cnvogelg/pardroid/README.md

The parbox project implements an external device attached to the
Amiga parallel port that allows to directly connect network or mass
storage devices.

Currently, devices based on Atmel's AVR8 controllers are supported on the
device side.
