cnvogelg/pardroid/docs/index.rst

The parbox Project
==================

.. toctree::
    :maxdepth: 2
    :hidden:

    pamela

The ``parbox`` project allows to attach 8 and 32 bit microcontrollers directly
to the parallel port of a classic Amiga computer. On multiple data channels
you can transfer data from and to attached SPI and I2C devices including
Ethernet network devices, SD Cards, small displays or real time clocks.

Contents
--------

* :doc:`pamela` - the parallel messaging layer description

Project Links
-------------

* Source is hosted on `GitHub <https://github.com/cnvogelg/parbox>`_
* docs are hosted on `ReadTheDocs <https://readthedocs.org/projects/parbox>`_
