cnvogelg/pardroid/hardware/pb_cpu_pipico/pb_cpu_pipico.kicad_pcb

## KiCad design hardware/pb_cpu_pipico/pb_cpu_pipico.kicad_pcb (2022-03-01)

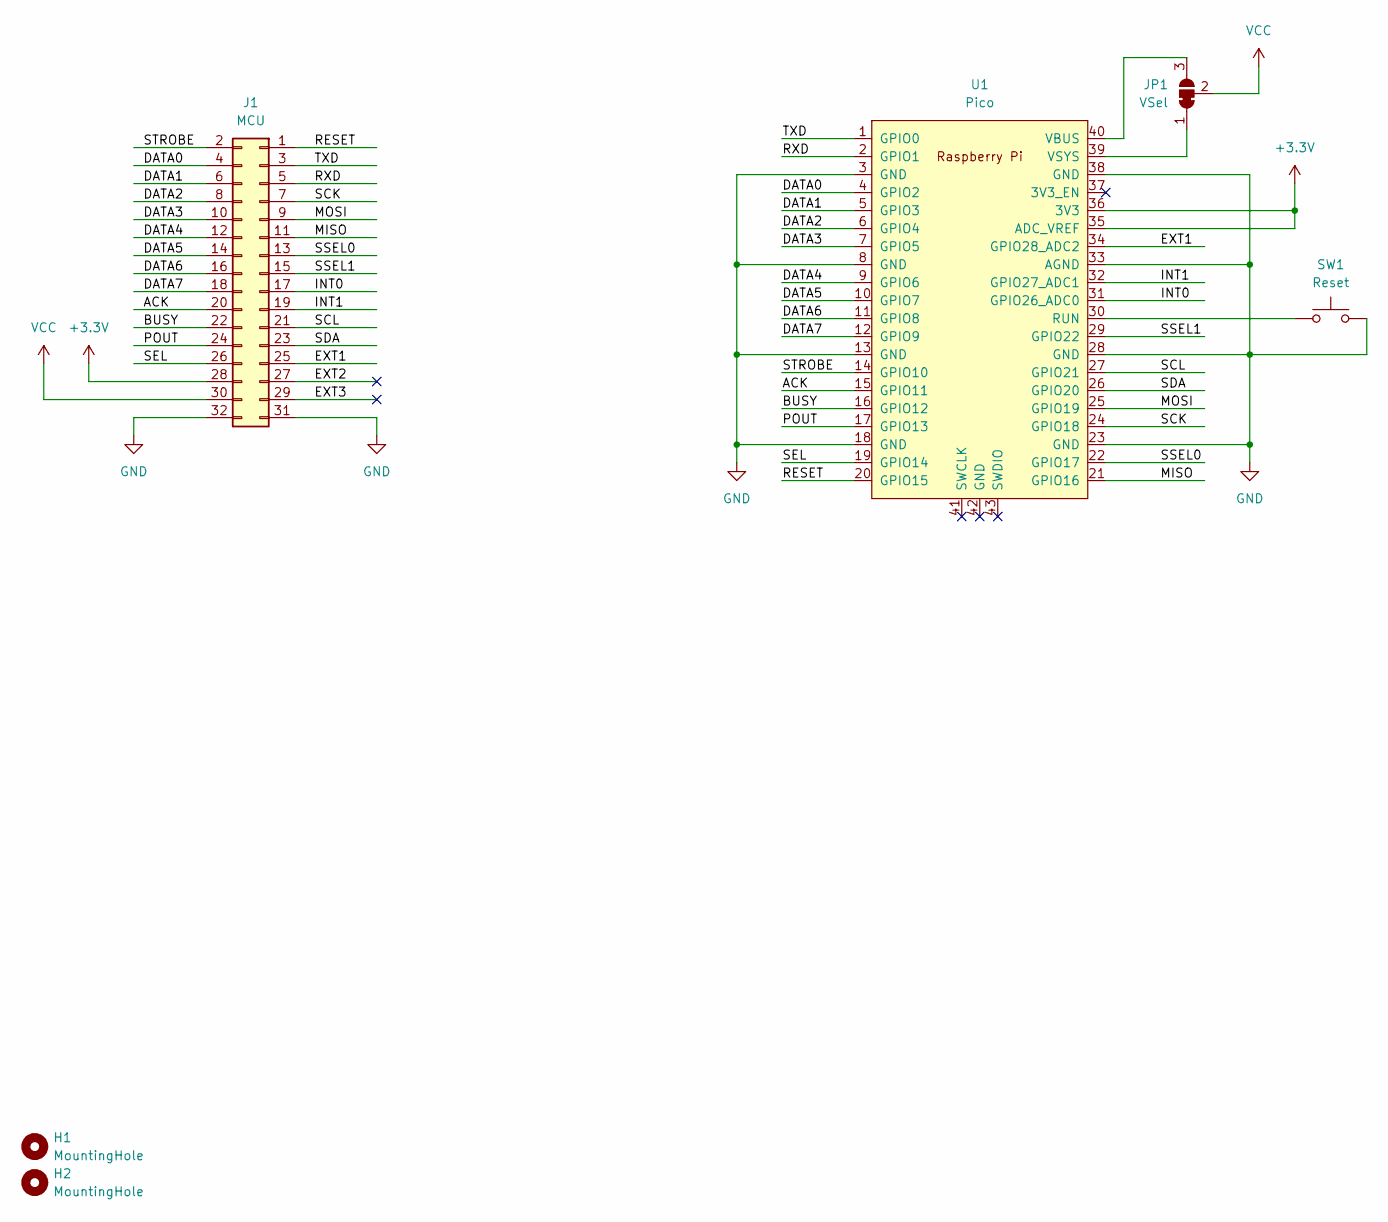
[picture p1: schematic pb_cpu_pipico.kicad_sch, AmiParBox CPU Board Pi Pico]

Parts:
H1, H2: MountingHole; MountingHole_3.2mm_M3_Pad
J1: MCU; PinHeader_2x16_P2.54mm_Vertical
JP1: VSel; SolderJumper-3_P1.3mm_Bridged2Bar12_Pad1.0x1.5mm
SW1: Reset; SW_PUSH_6mm
U1: Pico; RPi_Pico_SMD_TH

Connections:
+3V3: J1.28, U1.35 (ADC_VREF), U1.36 (3V3)
/ACK: J1.20, U1.15 (GPIO11)
/BUSY: J1.22, U1.16 (GPIO12)
/DATA0: J1.4, U1.4 (GPIO2)
/DATA1: J1.6, U1.5 (GPIO3)
/DATA2: J1.8, U1.6 (GPIO4)
/DATA3: J1.10, U1.7 (GPIO5)
/DATA4: J1.12, U1.9 (GPIO6)
/DATA5: J1.14, U1.10 (GPIO7)
/DATA6: J1.16, U1.11 (GPIO8)
/DATA7: J1.18, U1.12 (GPIO9)
/EXT1: J1.25, U1.34 (GPIO28_ADC2)
/EXT2: J1.27
/EXT3: J1.29
/INT0: J1.17, U1.31 (GPIO26_ADC0)
/INT1: J1.19, U1.32 (GPIO27_ADC1)
/MISO: J1.11, U1.21 (GPIO16)
/MOSI: J1.9, U1.25 (GPIO19)
/POUT: J1.24, U1.17 (GPIO13)
/RESET: J1.1, U1.20 (GPIO15)
/RXD: J1.5, U1.2 (GPIO1)
/SCK: J1.7, U1.24 (GPIO18)
/SCL: J1.21, U1.27 (GPIO21)
/SDA: J1.23, U1.26 (GPIO20)
/SEL: J1.26, U1.19 (GPIO14)
/SSEL0: J1.13, U1.22 (GPIO17)
/SSEL1: J1.15, U1.29 (GPIO22)
/STROBE: J1.2, U1.14 (GPIO10)
/TXD: J1.3, U1.1 (GPIO0)
GND: J1.31, J1.32, SW1.2, U1.3 (GND), U1.8 (GND), U1.13 (GND), U1.18 (GND), U1.23 (GND), U1.28 (GND), U1.33 (AGND), U1.38 (GND)
unnamed: JP1.1 (A), U1.39 (VSYS)
unnamed: JP1.3 (B), U1.40 (VBUS)
unnamed: SW1.1, U1.30 (RUN)
VCC: J1.30, JP1.2 (C)

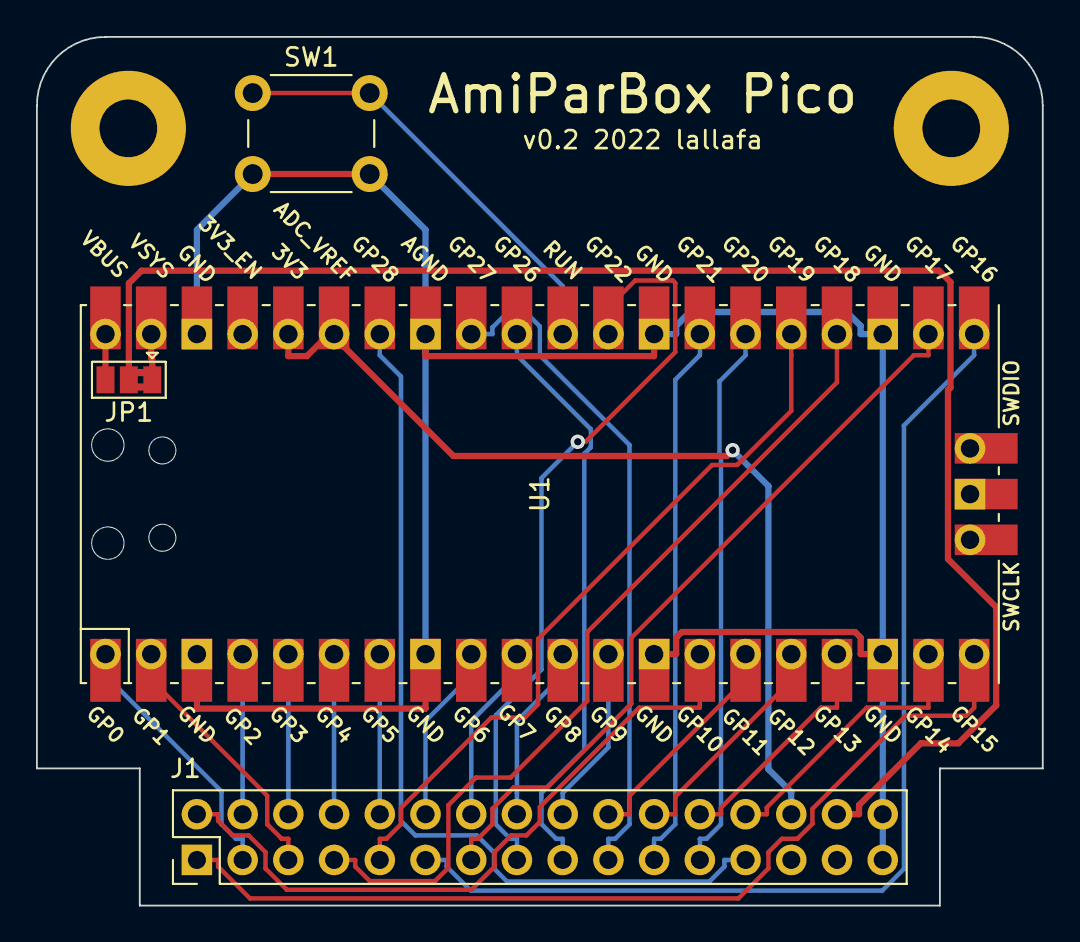
[picture p2: board pb_cpu_pipico.kicad_pcb from above]

Board: 2 copper layers, 55.9 x 48.3 mm, 6 parts (0 on the bottom side), 32 nets.
