cnvogelg/pardroid/hardware/pb_base/pb_base.kicad_pcb

## KiCad design hardware/pb_base/pb_base.kicad_pcb (2022-03-01)

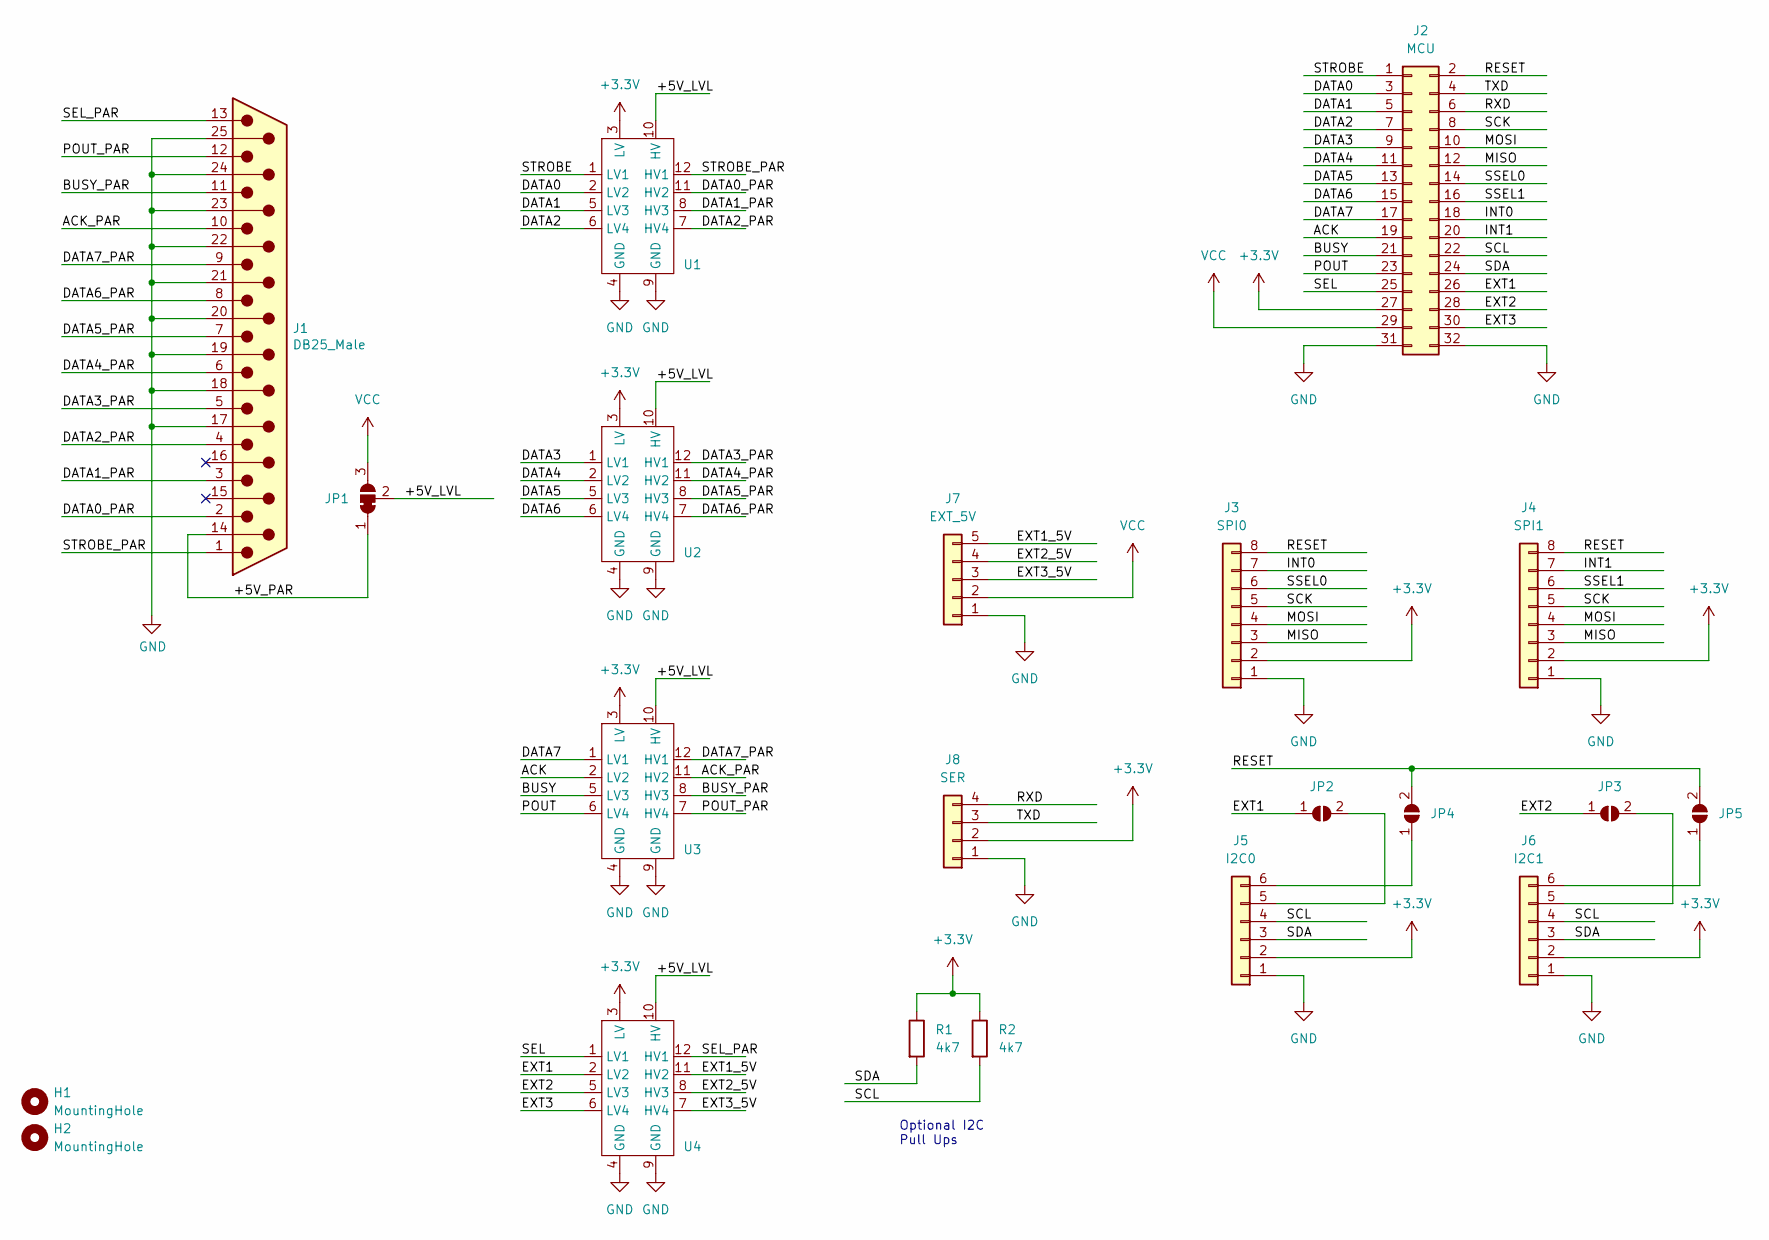
[picture p3: schematic pb_base.kicad_sch, ParBox Base Board]

Parts:
H1, H2: MountingHole; MountingHole_3.2mm_M3_Pad
J1: DB25_Male; DSUB-25_Male_Horizontal_P2.77x2.84mm_EdgePinOffset7.70mm_Ho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
J2: MCU; PinHeader_2x16_P2.54mm_Vertical
J3: SPI0; PinHeader_1x08_P2.54mm_Vertical
J4: SPI1; PinHeader_1x08_P2.54mm_Vertical
J5: I2C0; PinHeader_1x06_P2.54mm_Vertical
J6: I2C1; PinHeader_1x06_P2.54mm_Vertical
J7: EXT_5V; PinHeader_1x05_P2.54mm_Vertical
J8: SER; PinHeader_1x04_P2.54mm_Vertical
JP1: SolderJumper_3_Bridged12; PinHeader_1x03_P2.54mm_Vertical
JP2, JP3, JP4, JP5: SolderJumper_2_Open; PinHeader_1x02_P2.54mm_Vertical
R1, R2: 4k7; R_Axial_DIN0204_L3.6mm_D1.6mm_P5.08mm_Horizontal
U1, U2, U3, U4: LevelShifter_4; DIP-12_W10.16mm_LongPads

Connections:
+3V3: J2.27, J3.2, J4.2, J5.2, J6.2, J8.2, R1.1, R2.1, U1.3 (LV), U2.3 (LV), U3.3 (LV), U4.3 (LV)
/+5V_LVL: JP1.2 (C), U1.10 (HV), U2.10 (HV), U3.10 (HV), U4.10 (HV)
/+5V_PAR: J1.14, JP1.1 (A)
/ACK: J2.19, U3.2 (LV2)
/ACK_PAR: J1.10, U3.11 (HV2)
/BUSY: J2.21, U3.5 (LV3)
/BUSY_PAR: J1.11, U3.8 (HV3)
/DATA0: J2.3, U1.2 (LV2)
/DATA0_PAR: J1.2, U1.11 (HV2)
/DATA1: J2.5, U1.5 (LV3)
/DATA1_PAR: J1.3, U1.8 (HV3)
/DATA2: J2.7, U1.6 (LV4)
/DATA2_PAR: J1.4, U1.7 (HV4)
/DATA3: J2.9, U2.1 (LV1)
/DATA3_PAR: J1.5, U2.12 (HV1)
/DATA4: J2.11, U2.2 (LV2)
/DATA4_PAR: J1.6, U2.11 (HV2)
/DATA5: J2.13, U2.5 (LV3)
/DATA5_PAR: J1.7, U2.8 (HV3)
/DATA6: J2.15, U2.6 (LV4)
/DATA6_PAR: J1.8, U2.7 (HV4)
/DATA7: J2.17, U3.1 (LV1)
/DATA7_PAR: J1.9, U3.12 (HV1)
/EXT1: J2.26, JP2.1 (A), U4.2 (LV2)
/EXT1_5V: J7.5, U4.11 (HV2)
/EXT2: J2.28, JP3.1 (A), U4.5 (LV3)
/EXT2_5V: J7.4, U4.8 (HV3)
/EXT3: J2.30, U4.6 (LV4)
/EXT3_5V: J7.3, U4.7 (HV4)
/INT0: J2.18, J3.7
/INT1: J2.20, J4.7
/MISO: J2.12, J3.3, J4.3
/MOSI: J2.10, J3.4, J4.4
/POUT: J2.23, U3.6 (LV4)
/POUT_PAR: J1.12, U3.7 (HV4)
/RESET: J2.2, J3.8, J4.8, JP4.2 (B), JP5.2 (B)
/RXD: J2.6, J8.4
/SCK: J2.8, J3.5, J4.5
/SCL: J2.22, J5.4, J6.4, R2.2
/SDA: J2.24, J5.3, J6.3, R1.2
/SEL: J2.25, U4.1 (LV1)
/SEL_PAR: J1.13, U4.12 (HV1)
/SSEL0: J2.14, J3.6
/SSEL1: J2.16, J4.6
/STROBE: J2.1, U1.1 (LV1)
/STROBE_PAR: J1.1, U1.12 (HV1)
/TXD: J2.4, J8.3
GND: J1.17, J1.18, J1.19, J1.20, J1.21, J1.22, J1.23, J1.24, J1.25, J2.31, J2.32, J3.1, J4.1, J5.1, J6.1, J7.1, J8.1, U1.4 (GND), U1.9 (GND), U2.4 (GND), U2.9 (GND), U3.4 (GND), U3.9 (GND), U4.4 (GND), U4.9 (GND)
unnamed: J5.5, JP2.2 (B)
unnamed: J5.6, JP4.1 (A)
unnamed: J6.5, JP3.2 (B)
unnamed: J6.6, JP5.1 (A)
VCC: J2.29, J7.2, JP1.3 (B)

Notes on the sheet:
Optional I2C Pull Ups

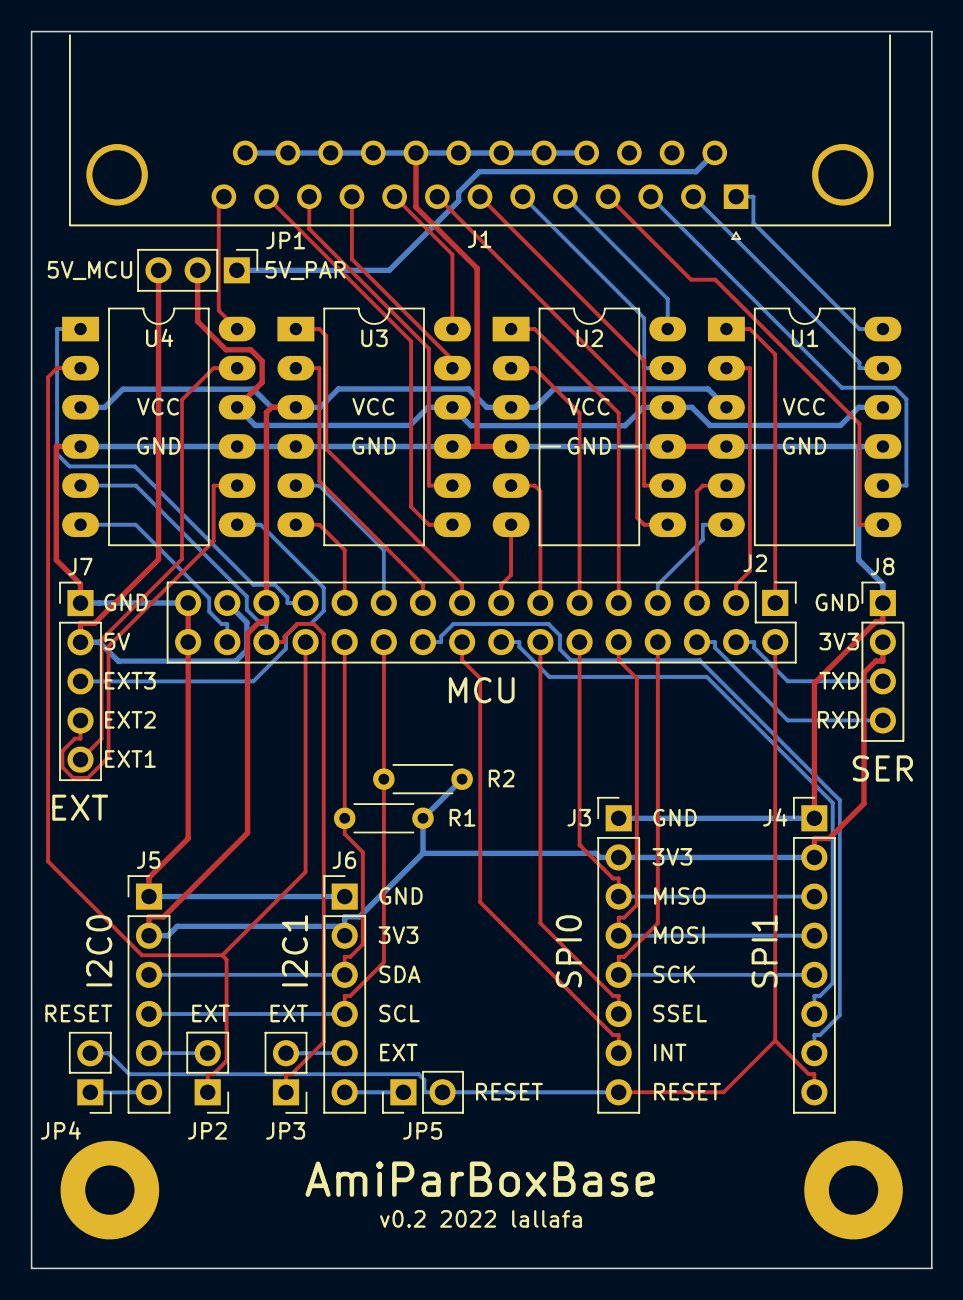
[picture p4: board pb_base.kicad_pcb from above]

Board: 2 copper layers, 58.4 x 80.3 mm, 21 parts (0 on the bottom side), 53 nets.
