cnvogelg/pardroid/hardware/pb_spi_net/pb_spi_net.kicad_pcb

## KiCad design hardware/pb_spi_net/pb_spi_net.kicad_pcb (2022-02-11)

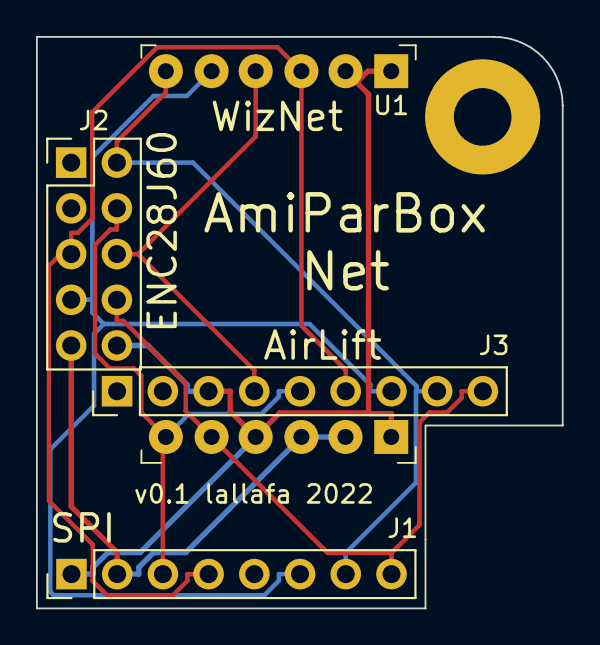
[picture p5: board pb_spi_net.kicad_pcb from above]

Board: 2 copper layers, 29.2 x 31.8 mm, 5 parts (0 on the bottom side), 8 nets.

Parts:
H1: MountingHole; MountingHole_3.2mm_M3_Pad
J1: SPI; PinHeader_1x08_P2.54mm_Vertical
J2: ENC28J60 Module; PinHeader_2x05_P2.54mm_Vertical
J3: AirLift; PinHeader_1x09_P2.54mm_Vertical
U1: WIZ820IO; Mag_Jack_Module_WIZ820IO

Connections:
+3V3: J1.2, J2.9, U1.J2-2 (3V3D), U1.J2-3 (3V3D)
/INT: J1.7, J2.2, J3.8, U1.J1-6 (nINT)
/MISO: J1.3, J2.4, J3.5, U1.J2-6 (MISO)
/MOSI: J1.4, J2.5, J3.6, U1.J1-3 (MOSI)
/RESET: J1.8, J2.8, J3.9, U1.J2-5 (nRESET)
/SCLK: J2.6, J3.4, U1.J1-4 (SCLK)
/SSEL: J1.6, J2.7, J3.7, U1.J1-5 (nSS)
GND: J1.1, J2.10, J3.3, U1.J1-1 (GND), U1.J1-2 (GND), U1.J2-1 (GND), U1.J2-4 (PWDN)
