cnvogelg/pardroid/hardware/teensy2.0/parbox_t2.kicad_pcb

## KiCad design hardware/teensy2.0/parbox_t2.kicad_pcb (2020-01-22)

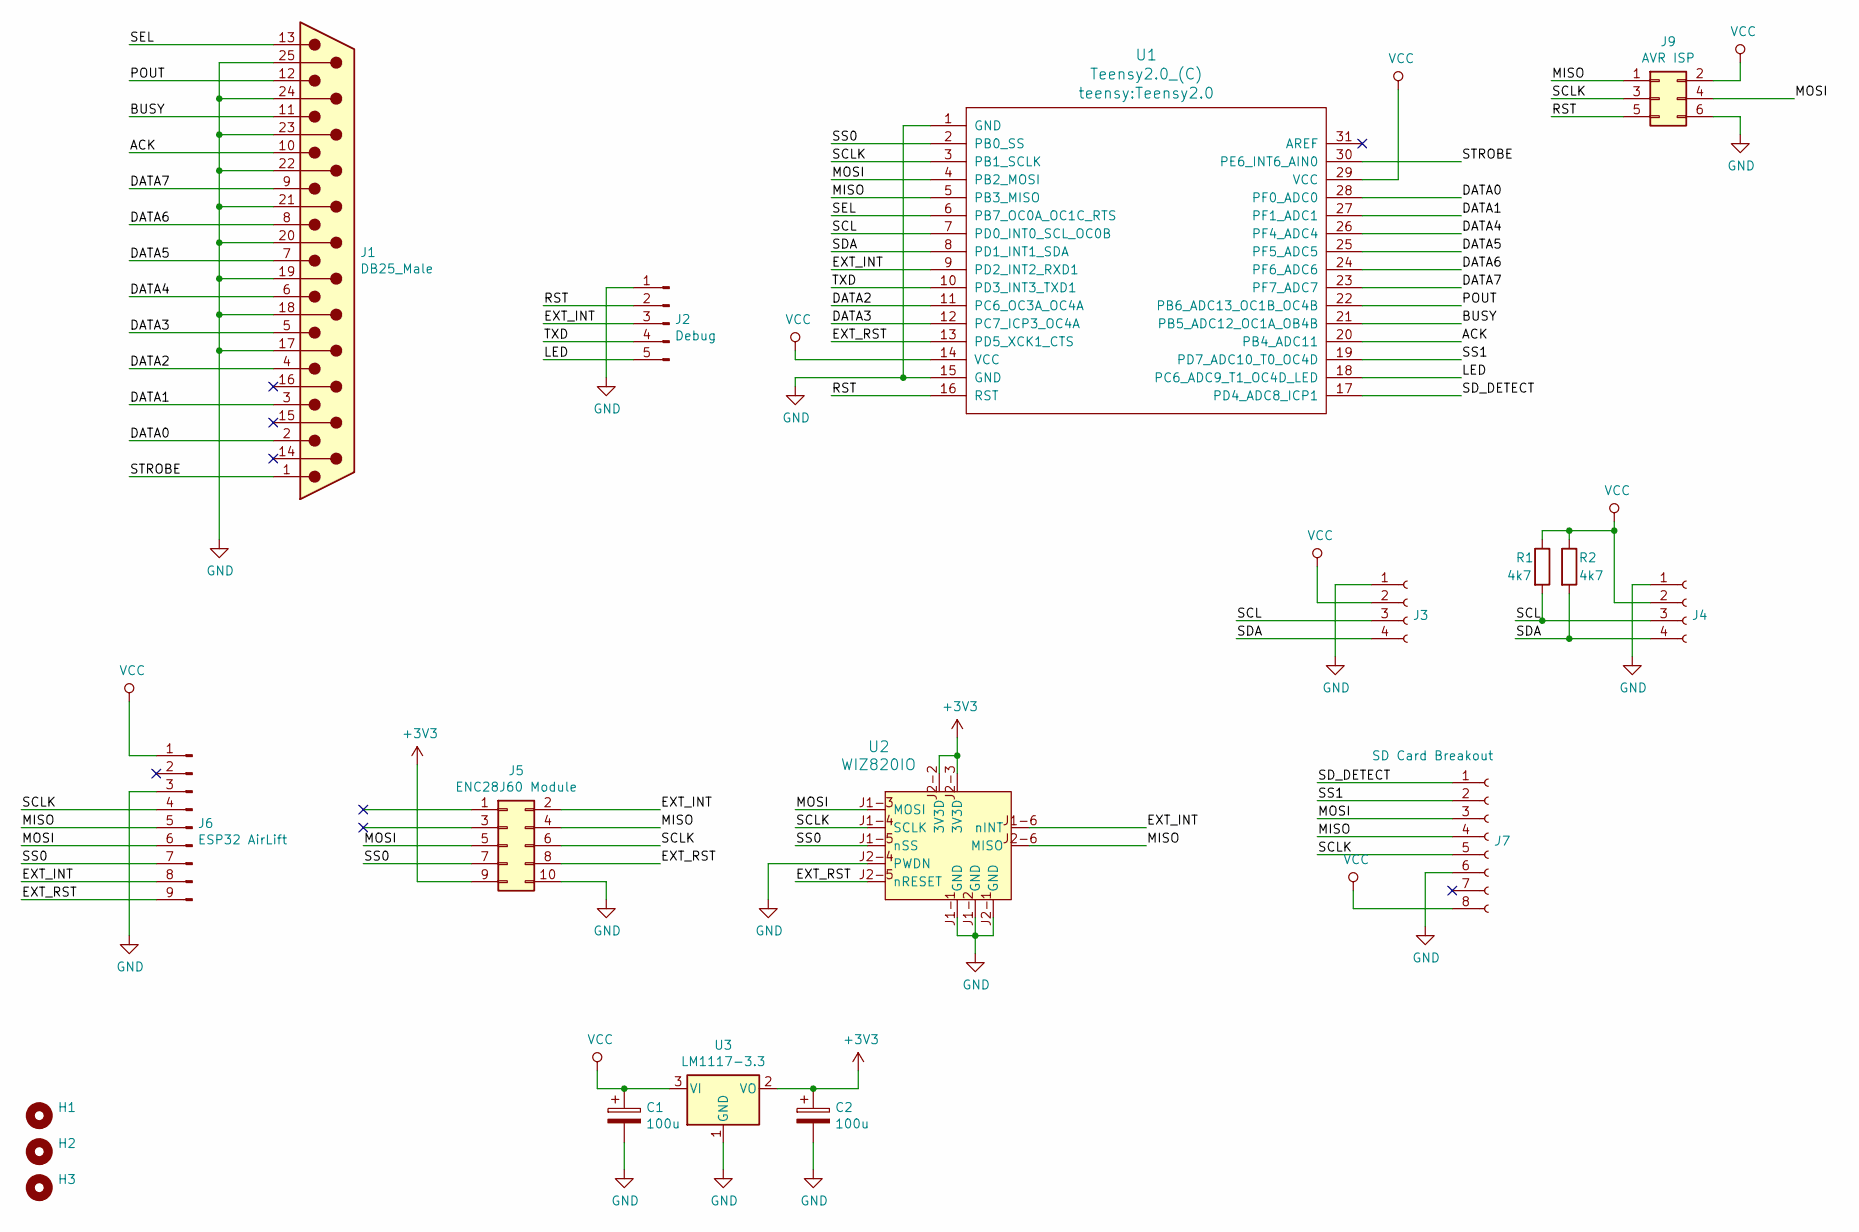
[picture p6: schematic parbox_t2.sch, AmiParBox T2]

Parts:
C1, C2: 100u; C_1210_3225Metric_Pad1.42x2.65mm_HandSolder
H1, H2, H3: MountingHole; MountingHole_2.7mm_M2.5_ISO14580_Pad
J1: DB25_Male; DSUB-25_Male_EdgeMount_P2.77mm
J2: Debug; PinHeader_1x05_P2.54mm_Vertical
J3: I2C OLED; PinHeader_1x04_P2.54mm_Vertical
J4: I2C Extra; PinHeader_1x04_P2.54mm_Vertical
J5: ENC28J60 Module; PinHeader_2x05_P2.54mm_Vertical
J6: ESP32 AirLift; PinHeader_1x09_P2.54mm_Vertical
J7: SD Card Breakout; PinHeader_1x08_P2.54mm_Vertical
J9: AVR ISP; PinHeader_2x03_P2.54mm_Vertical
R1, R2: 4k7; R_0805_2012Metric_Pad1.15x1.40mm_HandSolder
U1: Teensy2.0_(C); Teensy2.0
U2: WIZ820IO; Mag_Jack_Module_WIZ820IO; MPN WIZ820IO; Digi-Key_PN 1278-1015-ND
U3: LM1117-3.3; SOT-223-3_TabPin2

Connections:
+3V3: C2.1, J5.9, U2.J2-2 (3V3D), U2.J2-3 (3V3D), U3.2 (VO)
/ACK: J1.10, U1.20 (PB4_ADC11)
/BUSY: J1.11, U1.21 (PB5_ADC12_OC1A_OB4B)
/DATA0: J1.2, U1.28 (PF0_ADC0)
/DATA1: J1.3, U1.27 (PF1_ADC1)
/DATA2: J1.4, U1.11 (PC6_OC3A_OC4A)
/DATA3: J1.5, U1.12 (PC7_ICP3_OC4A)
/DATA4: J1.6, U1.26 (PF4_ADC4)
/DATA5: J1.7, U1.25 (PF5_ADC5)
/DATA6: J1.8, U1.24 (PF6_ADC6)
/DATA7: J1.9, U1.23 (PF7_ADC7)
/EXT_INT: J2.3, J5.2, J6.8, U1.9 (PD2_INT2_RXD1), U2.J1-6 (nINT)
/EXT_RST: J5.8, J6.9, U1.13 (PD5_XCK1_CTS), U2.J2-5 (nRESET)
/LED: J2.5, U1.18 (PC6_ADC9_T1_OC4D_LED)
/MISO: J5.4, J6.5, J7.4, J9.1, U1.5 (PB3_MISO), U2.J2-6 (MISO)
/MOSI: J5.5, J6.6, J7.3, J9.4, U1.4 (PB2_MOSI), U2.J1-3 (MOSI)
/POUT: J1.12, U1.22 (PB6_ADC13_OC1B_OC4B)
/RST: J2.2, J9.5, U1.16 (RST)
/SCL: J3.3, J4.3, R1.2, U1.7 (PD0_INT0_SCL_OC0B)
/SCLK: J5.6, J6.4, J7.5, J9.3, U1.3 (PB1_SCLK), U2.J1-4 (SCLK)
/SDA: J3.4, J4.4, R2.2, U1.8 (PD1_INT1_SDA)
/SD_DETECT: J7.1, U1.17 (PD4_ADC8_ICP1)
/SEL: J1.13, U1.6 (PB7_OC0A_OC1C_RTS)
/SS0: J5.7, J6.7, U1.2 (PB0_SS), U2.J1-5 (nSS)
/SS1: J7.2, U1.19 (PD7_ADC10_T0_OC4D)
/STROBE: J1.1, U1.30 (PE6_INT6_AIN0)
/TXD: J2.4, U1.10 (PD3_INT3_TXD1)
GND: C1.2, C2.2, J1.17, J1.18, J1.19, J1.20, J1.21, J1.22, J1.23, J1.24, J1.25, J2.1, J3.1, J4.1, J5.10, J6.3, J7.6, J9.6, U1.1 (GND), U1.15 (GND), U2.J1-1 (GND), U2.J1-2 (GND), U2.J2-1 (GND), U2.J2-4 (PWDN), U3.1 (GND)
VCC: C1.1, J3.2, J4.2, J6.1, J7.8, J9.2, R1.1, R2.1, U1.14 (VCC), U1.29 (VCC), U3.3 (VI)

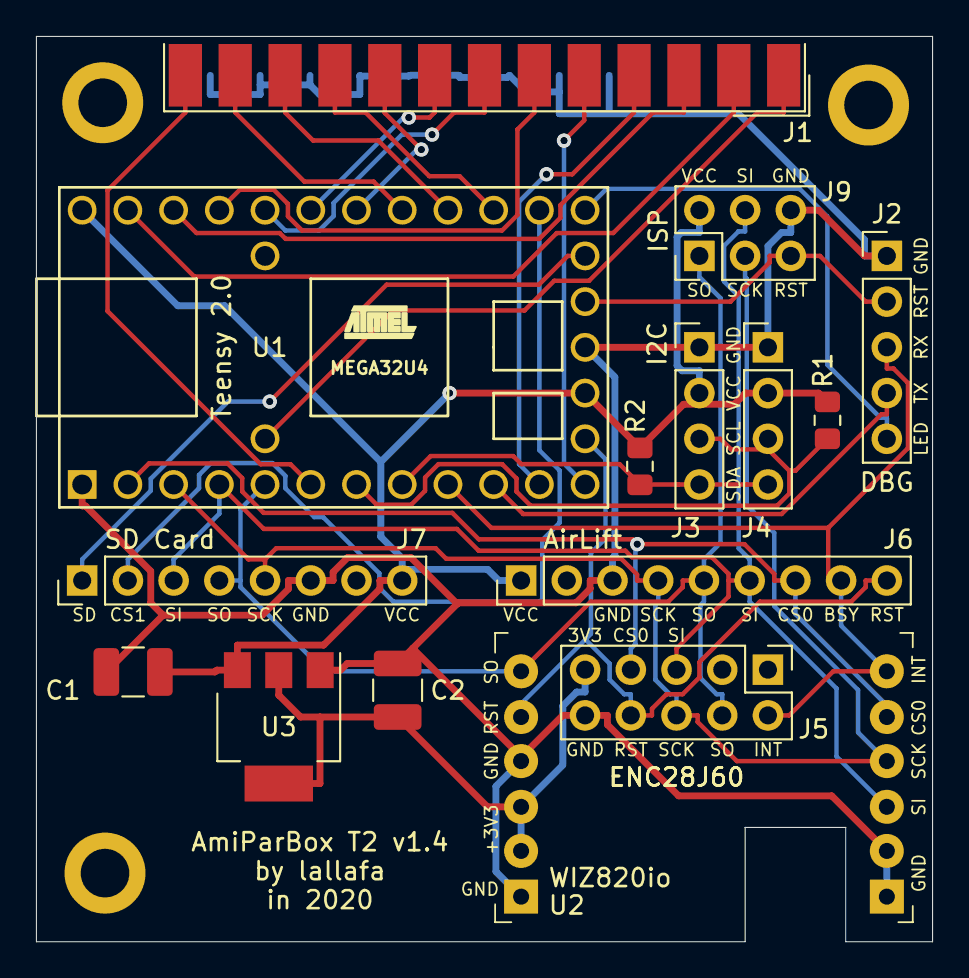
[picture p7: board parbox_t2.kicad_pcb from above]

Board: 2 copper layers, 49.8 x 50.3 mm, 18 parts (0 on the bottom side), 29 nets.
