cnvogelg/pardroid/hardware/teensy3.2/parbox_t32.kicad_pcb

## KiCad design hardware/teensy3.2/parbox_t32.kicad_pcb (2020-01-09)

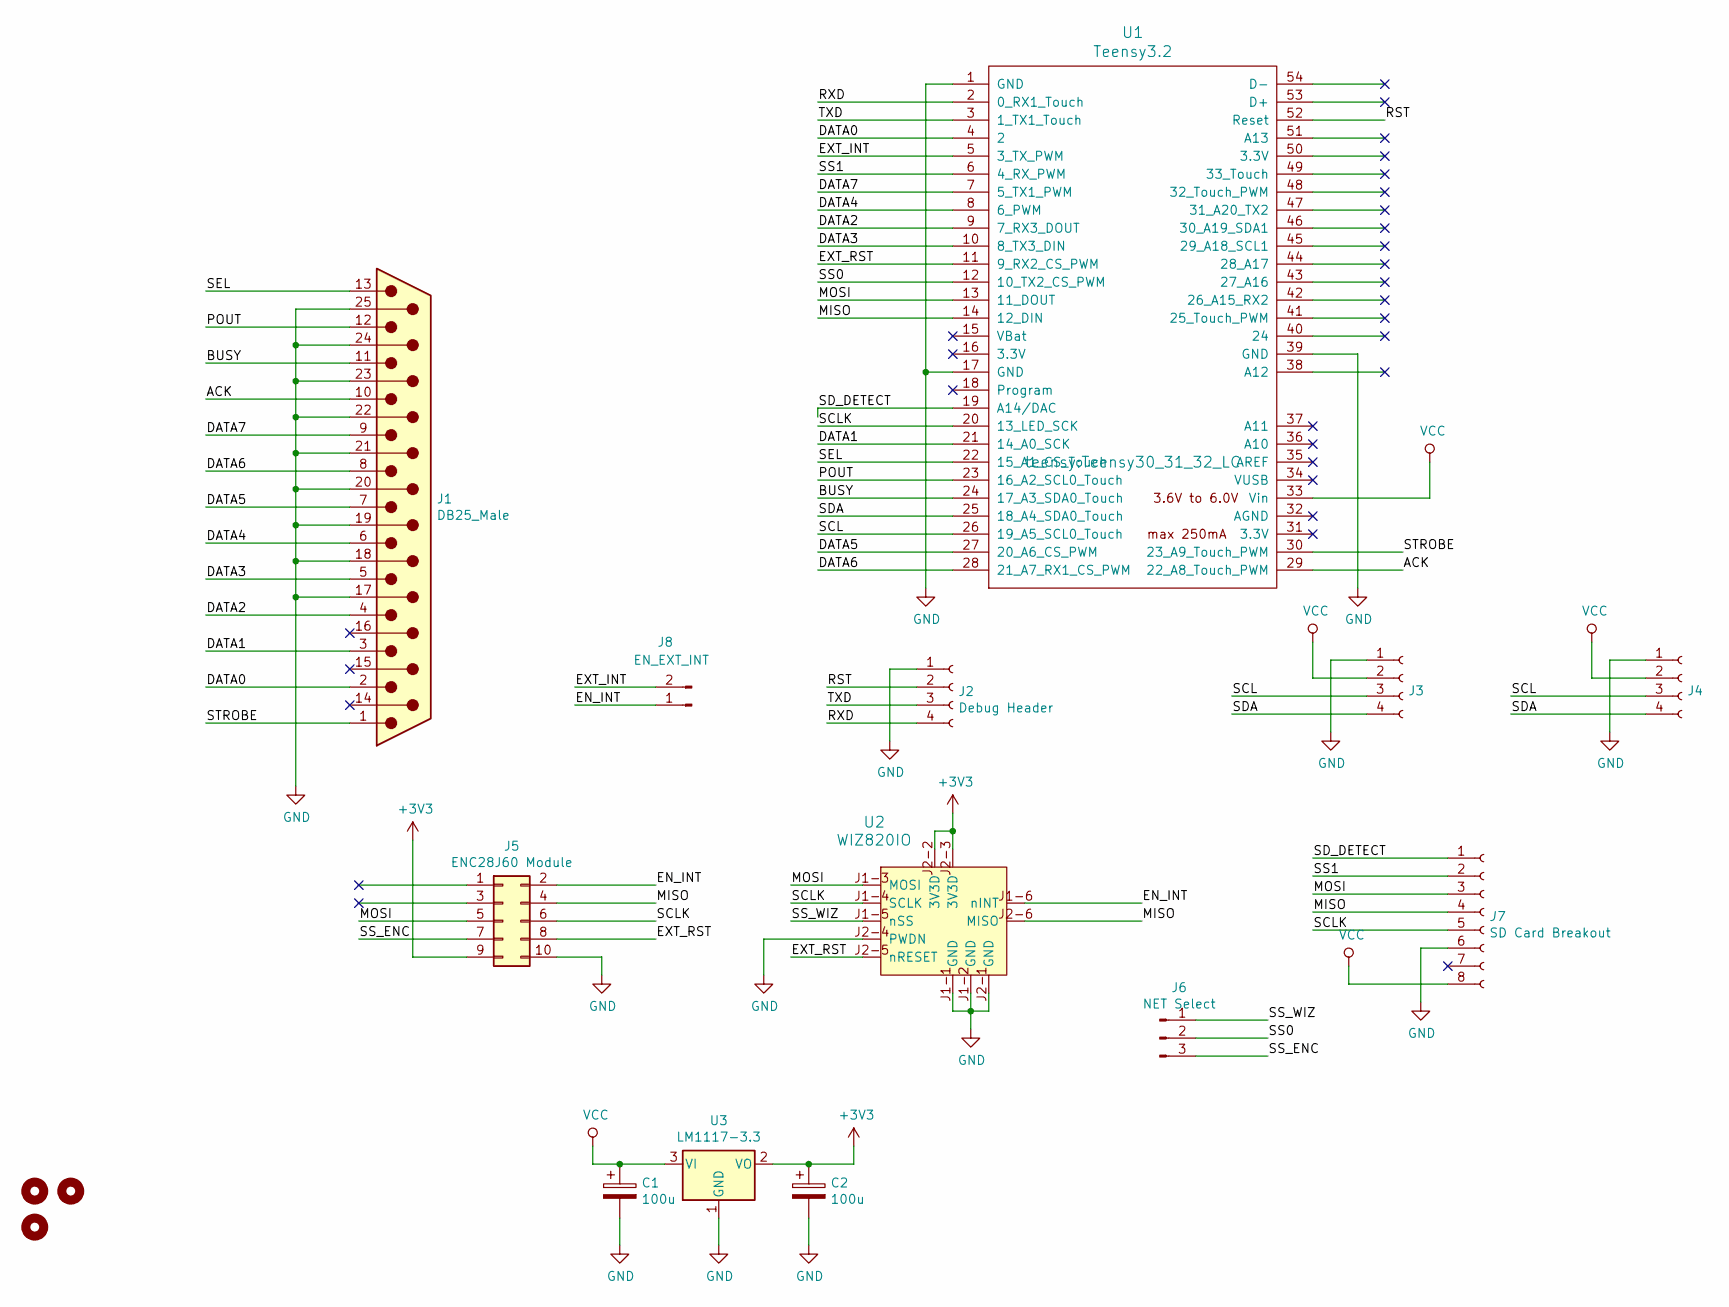
[picture p8: schematic parbox_t32.sch, AmiParBox T3.2]

Parts:
C1, C2: 100u; C_1210_3225Metric_Pad1.42x2.65mm_HandSolder
H1, H2, H3: MountingHole; MountingHole_2.7mm_M2.5_Pad
J1: DB25_Male; DSUB-25_Female_EdgeMount_P2.77mm
J2: Debug Header; PinHeader_1x04_P2.54mm_Vertical
J3: I2C OLED; PinHeader_1x04_P2.54mm_Vertical
J4: I2C Extra; PinHeader_1x04_P2.54mm_Vertical
J5: ENC28J60 Module; PinHeader_2x05_P2.54mm_Vertical
J6: NET Select; SolderJumper-3_P1.3mm_Open_RoundedPad1.0x1.5mm_NumberLabels
J7: SD Card Breakout; PinHeader_1x08_P2.54mm_Vertical
J8: EN_EXT_INT; SolderJumper-2_P1.3mm_Bridged_RoundedPad1.0x1.5mm
U1: Teensy3.2; Teensy30_31_32_LC
U2: WIZ820IO; Mag_Jack_Module_WIZ820IO; MPN WIZ820IO; Digi-Key_PN 1278-1015-ND
U3: LM1117-3.3; SOT-223-3_TabPin2

Connections:
+3V3: C2.1, J5.9, U2.J2-2 (3V3D), U2.J2-3 (3V3D), U3.2 (VO)
/ACK: J1.10, U1.29 (22_A8_Touch_PWM)
/BUSY: J1.11, U1.24 (17_A3_SDA0_Touch)
/DATA0: J1.2, U1.4 (2)
/DATA1: J1.3, U1.21 (14_A0_SCK)
/DATA2: J1.4, U1.9 (7_RX3_DOUT)
/DATA3: J1.5, U1.10 (8_TX3_DIN)
/DATA4: J1.6, U1.8 (6_PWM)
/DATA5: J1.7, U1.27 (20_A6_CS_PWM)
/DATA6: J1.8, U1.28 (21_A7_RX1_CS_PWM)
/DATA7: J1.9, U1.7 (5_TX1_PWM)
/EN_INT: J5.2, J8.1, U2.J1-6 (nINT)
/EXT_INT: J8.2, U1.5 (3_TX_PWM)
/EXT_RST: J5.8, U1.11 (9_RX2_CS_PWM), U2.J2-5 (nRESET)
/MISO: J5.4, J7.4, U1.14 (12_DIN), U2.J2-6 (MISO)
/MOSI: J5.5, J7.3, U1.13 (11_DOUT), U2.J1-3 (MOSI)
/POUT: J1.12, U1.23 (16_A2_SCL0_Touch)
/RST: J2.2, U1.52 (Reset)
/RXD: J2.4, U1.2 (0_RX1_Touch)
/SCL: J3.3, J4.3, U1.26 (19_A5_SCL0_Touch)
/SCLK: J5.6, J7.5, U1.20 (13_LED_SCK), U2.J1-4 (SCLK)
/SDA: J3.4, J4.4, U1.25 (18_A4_SDA0_Touch)
/SD_DETECT: J7.1, U1.19 (A14/DAC)
/SEL: J1.13, U1.22 (15_A1_CS_Touch)
/SS0: J6.2, U1.12 (10_TX2_CS_PWM)
/SS1: J7.2, U1.6 (4_RX_PWM)
/SS_ENC: J5.7, J6.3
/SS_WIZ: J6.1, U2.J1-5 (nSS)
/STROBE: J1.1, U1.30 (23_A9_Touch_PWM)
/TXD: J2.3, U1.3 (1_TX1_Touch)
GND: C1.2, C2.2, J1.17, J1.18, J1.19, J1.20, J1.21, J1.22, J1.23, J1.24, J1.25, J2.1, J3.1, J4.1, J5.10, J7.6, U1.1 (GND), U1.17 (GND), U1.39 (GND), U2.J1-1 (GND), U2.J1-2 (GND), U2.J2-1 (GND), U2.J2-4 (PWDN), U3.1 (GND)
VCC: C1.1, J3.2, J4.2, J7.8, U1.33 (Vin), U3.3 (VI)

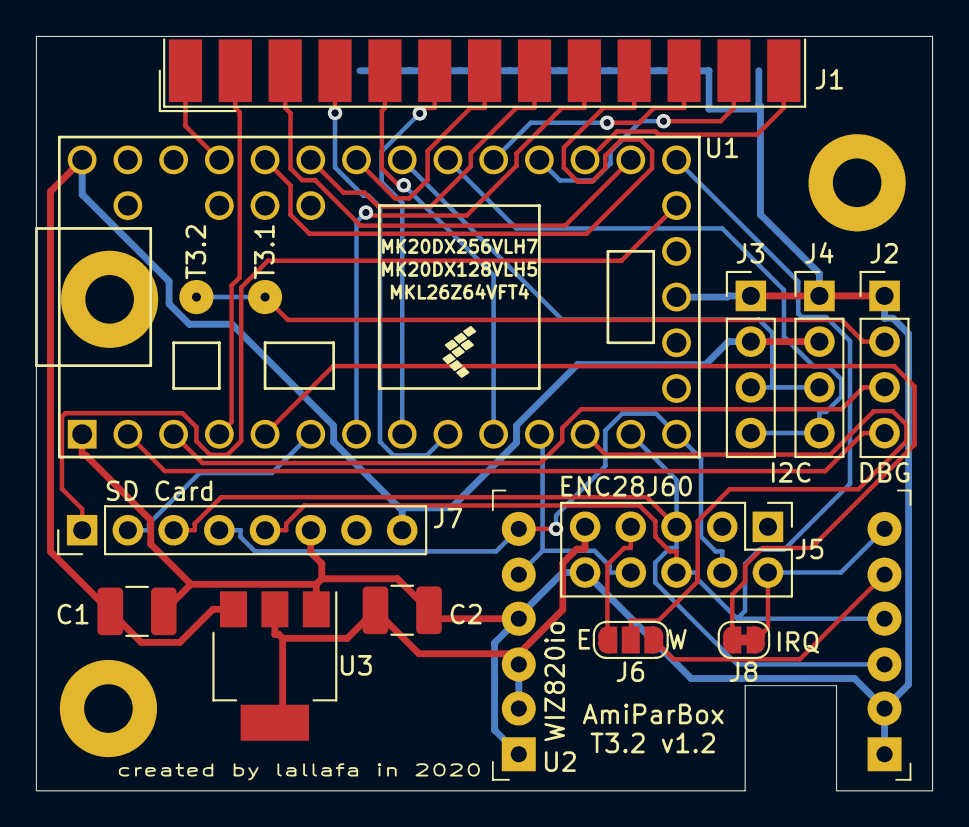
[picture p9: board parbox_t32.kicad_pcb from above]

Board: 2 copper layers, 49.8 x 41.9 mm, 16 parts (0 on the bottom side), 32 nets.
