cnvogelg/pardroid/mcu/src/pamela/pamela.c

#include "types.h"
#include "arch.h"
#include "autoconf.h"

#define DEBUG CONFIG_DEBUG_PAMELA

#include "debug.h"
#include "proto_io.h"
#include "pamela.h"
#include "pamela_int.h"

HANDLER_TABLE_DECLARE

// the channel array
static pamela_channel_t pamela_channels[PAMELA_NUM_CHANNELS];
// the mask of active channels
static u16 active_channels;

void pamela_init(void)
{
  DS("pam_init"); DNL;
  proto_io_init();

  active_channels = 0;

  // setup channels
  for(u08 i=0;i<PAMELA_NUM_CHANNELS;i++) {
    pamela_channel_t *chn = &pamela_channels[i];
    chn->status = 0;
    chn->rx_buf.size = 0;
    chn->rx_buf.data = NULL;
    chn->tx_buf.size = 0;
    chn->tx_buf.data = NULL;
    chn->service = NULL;
    chn->port = 0;
    chn->chan_id = i;
    chn->slot_id = PAMELA_EMPTY_SLOT;
    chn->flags = 0;
  }

  // setup services
  for(u08 i=0;i<HANDLER_TABLE_GET_SIZE();i++) {
    pamela_service_t *srv = &pamela_services[i];
    srv->channels = 0;
  }

  DS("pam_init done"); DNL;
}

static void pamela_channel_work(pamela_channel_t *chn);

void pamela_work(void)
{
  proto_io_handle_cmd();

  // process active channels
  for(u08 i=0;i<PAMELA_NUM_CHANNELS;i++) {
    pamela_channel_t *chn = &pamela_channels[i];
    // only work in active channels
    u08 active = chn->status & PAMELA_STATUS_ACTIVE_MASK;
    if(active != 0) {
      pamela_channel_work(chn);
    }

    // channel task is active?
    if((chn->flags & PAMELA_CHANNEL_FLAG_TASK) != 0) {
      pamela_handler_ptr_t handler = HANDLER_TABLE_GET_ENTRY(chn->service->srv_id);
      hnd_channel_task_func_t func = HANDLER_FUNC_CHANNEL_TASK(handler);
      DS("ch task:"); DB(i); DNL;
      func(i);
    }
  }

  // process service tasks
  for(u08 i=0;i<HANDLER_TABLE_GET_SIZE();i++) {
    pamela_handler_ptr_t handler = HANDLER_TABLE_GET_ENTRY(i);
    hnd_service_task_func_t func = HANDLER_FUNC_SERVICE_TASK(handler);
    if(func != NULL) {
      DS("srv task"); DB(i); DNL;
      func(i);
    }
  }
}

// ----- internal helpers -----

pamela_channel_t *pamela_get_channel(u08 chn)
{
  return &pamela_channels[chn];
}

pamela_service_t *pamela_find_service(u16 port)
{
  for(u08 i=0;i<HANDLER_TABLE_GET_SIZE();i++) {
    pamela_service_t *srv = &pamela_services[i];
    pamela_handler_ptr_t handler = HANDLER_TABLE_GET_ENTRY(i);
    u16 port_begin = HANDLER_GET_PORT_BEGIN(handler);
    u16 port_end = HANDLER_GET_PORT_END(handler);
    if((port >= port_begin) && (port <= port_end)) {
      return srv;
    }
  }
  return NULL;
}

u08 pamela_find_slot(pamela_service_t *srv)
{
  pamela_handler_ptr_t handler = HANDLER_TABLE_GET_ENTRY(srv->srv_id);
  u08 max_slots = HANDLER_GET_MAX_SLOTS(handler);

  // try all slots
  for(u08 slot=0;slot<max_slots;slot++) {
    // check if any channel uses this slot already
    u08 found = 0;
    for(u08 i=0;i<PAMELA_NUM_CHANNELS;i++) {
      pamela_channel_t *chn = &pamela_channels[i];
      if(chn->service == srv) {
        if(chn->slot_id == slot) {
          found = 1;
          break;
        }
      }
    }

    // slot unused?
    if(!found) {
      return slot;
    }
  }
  // no slot found
  return PAMELA_EMPTY_SLOT;
}

void pamela_set_status(pamela_channel_t *pc, u08 status)
{
  pc->status &= ~PAMELA_STATUS_STATE_MASK;
  pc->status |= status;
}

void pamela_set_error(pamela_channel_t *pc, u08 error)
{
  pc->status &= ~PAMELA_STATUS_STATE_MASK;
  pc->status |= PAMELA_STATUS_ERROR;
  pc->error = error;
}

void pamela_set_open_error(pamela_channel_t *pc, u08 error)
{
  pc->status &= ~PAMELA_STATUS_STATE_MASK;
  pc->status |= PAMELA_STATUS_OPEN_ERROR;
  pc->error = error;
}

// ----- read -----

static void pamela_read_reply(pamela_channel_t *pc)
{
  pamela_buf_t *buf = &pc->rx_buf;

  // size is not the requested size
  if(pc->rx_org_size != buf->size) {
    pc->status |= PAMELA_STATUS_READ_SIZE;
  }

  // read is now pending
  pc->status |= PAMELA_STATUS_READ_READY;
  pc->status &= ~PAMELA_STATUS_READ_PRE;

  // setup next block transfer
  buf->offset = 0;
  if(buf->size <= pc->mtu) {
    buf->blk_size = buf->size;
  } else {
    buf->blk_size = pc->mtu;
  }

  DS("[rp:"); DB(pc->chan_id); DC('='); DW(buf->size); DC('+'); DW(buf->blk_size); DC(']');

  // notify host
  proto_io_event_mask_add_chn(pc->chan_id);
}

static void pamela_read_done(pamela_channel_t *pc)
{
  pc->status &= ~PAMELA_STATUS_READ_MASK;
  pc->rx_buf.data = NULL;
  pc->rx_buf.size = 0;

  DS("[rd:"); DB(pc->chan_id); DC(']'); DNL;

  // notify host
  proto_io_event_mask_add_chn(pc->chan_id);
}

void pamela_read_pre_work(pamela_channel_t *chn, pamela_handler_ptr_t handler,
  u08 state)
{
  DS("[rew:");

  // call read_pre()
  u08 result = PAMELA_HANDLER_OK;
  if(handler != NULL) {
    hnd_read_func_t read_pre_func = HANDLER_FUNC_READ_PRE(handler);
    if(read_pre_func != NULL) {
      result = read_pre_func(chn->chan_id, state, &chn->rx_buf);
    }
  }
  DB(result);

  if(result == PAMELA_HANDLER_OK) {
    pamela_read_reply(chn);
  } else if(result != PAMELA_HANDLER_POLL) {
    pamela_set_error(chn, result);
    pamela_read_done(chn);
  }

  DC(']');
}

void pamela_read_post_work(pamela_channel_t *chn, pamela_handler_ptr_t handler,
  u08 state)
{
  DS("[row:");

  // call read_post()
  u08 result = PAMELA_HANDLER_OK;
  if(handler != NULL) {
    hnd_read_func_t read_post_func = HANDLER_FUNC_READ_POST(handler);
    if(read_post_func != NULL) {
      result = read_post_func(chn->chan_id, state, &chn->rx_buf);
    }
  }
  DB(result);

  // read is done
  if(result == PAMELA_HANDLER_OK) {
    pamela_read_done(chn);
  } else if(result != PAMELA_HANDLER_POLL) {
    pamela_set_error(chn, result);
    pamela_read_done(chn);
  }

  DC(']');
}

// ----- write -----

static void pamela_write_reply(pamela_channel_t *pc)
{
  pamela_buf_t *buf = &pc->tx_buf;

  // size is not the requested size
  if(pc->tx_org_size != buf->size) {
    pc->status |= PAMELA_STATUS_WRITE_SIZE;
  }

  // write is now pending
  pc->status |= PAMELA_STATUS_WRITE_READY;
  pc->status &= ~PAMELA_STATUS_WRITE_PRE;

  // setup next block transfer
  buf->offset = 0;
  if(buf->size <= pc->mtu) {
    buf->blk_size = buf->size;
  } else {
    buf->blk_size = pc->mtu;
  }

  DS("[wp:"); DB(pc->chan_id); DC('='); DW(buf->size); DC('+'); DW(buf->blk_size); DC(']');

  // notify host
  proto_io_event_mask_add_chn(pc->chan_id);
}

static void pamela_write_done(pamela_channel_t *pc)
{
  pc->status &= ~PAMELA_STATUS_WRITE_MASK;
  pc->tx_buf.data = NULL;
  pc->tx_buf.size = 0;

  DS("[wd:"); DB(pc->chan_id); DC(']'); DNL;

  // notify host
  proto_io_event_mask_add_chn(pc->chan_id);
}

void pamela_write_pre_work(pamela_channel_t *chn, pamela_handler_ptr_t handler,
  u08 state)
{
  DS("[wew:");

  u08 result = PAMELA_HANDLER_OK;
  if(handler != NULL) {
    hnd_write_func_t write_pre_func = HANDLER_FUNC_WRITE_PRE(handler);
    if(write_pre_func != NULL) {
      result = write_pre_func(chn->chan_id, state, &chn->tx_buf);
    }
  }
  DB(result);

  if(result == PAMELA_HANDLER_OK) {
    pamela_write_reply(chn);
  } else if(result != PAMELA_HANDLER_POLL) {
    pamela_set_error(chn, result);
    pamela_write_done(chn);
  }

  DC(']');
}

void pamela_write_post_work(pamela_channel_t *chn, pamela_handler_ptr_t handler,
  u08 state)
{
  DS("[wow:");

  u08 result = PAMELA_HANDLER_OK;
  if(handler != NULL) {
    hnd_write_func_t write_post_func = HANDLER_FUNC_WRITE_POST(handler);
    if(write_post_func != NULL) {
      result = write_post_func(chn->chan_id, state, &chn->tx_buf);
    }
  }
  DB(result);

  if(result == PAMELA_HANDLER_OK) {
    pamela_write_done(chn);
  } else if(result != PAMELA_HANDLER_POLL) {
    pamela_set_error(chn, result);
    pamela_write_done(chn);
  }

  DC(']');
}

// ----- open -----

static void pamela_open_done(pamela_channel_t *pc, u08 error)
{
  if(error == PAMELA_HANDLER_OK) {
    pamela_set_status(pc, PAMELA_STATUS_ACTIVE);
  } else {
    pamela_set_open_error(pc, error);
  }

  // set service active
  pc->service->channels |= 1 << pc->chan_id;

  DS("[Od:"); DB(error); DC(']');

  // trigger event
  proto_io_event_mask_add_chn(pc->chan_id);
}

void pamela_open_work(pamela_channel_t *chn, pamela_handler_ptr_t handler, u08 state)
{
  DS("[Ow:"); DB(chn->chan_id); DC(',');
  if(handler != NULL) {
    hnd_open_func_t open_func = HANDLER_FUNC_OPEN(handler);
    if(open_func != NULL) {
      pamela_set_status(chn, PAMELA_STATUS_OPENING);
      u08 res = open_func(chn->chan_id, state, chn->port);
      // if not PAMELA_HANDLER_POLL then open is done
      if((res == PAMELA_HANDLER_OK) || (res != PAMELA_HANDLER_POLL)) {
        pamela_open_done(chn, res);
      }
    } else {
      // quick open
      pamela_open_done(chn, PAMELA_HANDLER_OK);
    }
  } else {
    // quick open
    pamela_open_done(chn, PAMELA_HANDLER_OK);
  }
  DC(']');
}

// ----- close -----

static void pamela_close_done(pamela_channel_t *pc)
{
  pamela_set_status(pc, PAMELA_STATUS_INACTIVE);

  // clear channel
  pc->service->channels &= ~(1 << pc->chan_id);

  pc->status = 0;
  pc->service = NULL;
  pc->port = 0;
  pc->slot_id = PAMELA_EMPTY_SLOT;

  DS("[Cd]");

  // trigger event
  proto_io_event_mask_add_chn(pc->chan_id);
}

void pamela_close_work(pamela_channel_t *chn, pamela_handler_ptr_t handler, u08 state)
{
  DS("[Cw:"); DB(chn->chan_id); DC(',');
  if(handler != NULL) {
    hnd_close_func_t close_func = HANDLER_FUNC_CLOSE(handler);
    if(close_func != NULL) {
      pamela_set_status(chn, PAMELA_STATUS_CLOSING);
      u08 res = close_func(chn->chan_id, state);
      // if not PAMELA_HANDLER_POLL then close is done
      if(res == PAMELA_HANDLER_OK) {
        pamela_close_done(chn);
      }
    } else {
      // quick close without handler func
      pamela_close_done(chn);
    }
  } else {
    // quick close without handler func
    pamela_close_done(chn);
  }
  DC(']');
}

// ----- reset -----

static void pamela_reset_done(pamela_channel_t *pc)
{
  pamela_set_status(pc, PAMELA_STATUS_ACTIVE);

  DS("[Rd]");

  // trigger event
  proto_io_event_mask_add_chn(pc->chan_id);
}

void pamela_reset_work(pamela_channel_t *chn, pamela_handler_ptr_t handler, u08 state)
{
  DS("[Rw:"); DB(chn->chan_id); DC(',');
  if(handler != NULL) {
    hnd_reset_func_t reset_func = HANDLER_FUNC_RESET(handler);
    if(reset_func != NULL) {
      pamela_set_status(chn, PAMELA_STATUS_RESETTING);
      u08 res = reset_func(chn->chan_id, state);
      // if not PAMELA_HANDLER_POLL then close is done
      if(res == PAMELA_HANDLER_OK) {
        pamela_reset_done(chn);
      }
    } else {
      pamela_reset_done(chn);
    }
  } else {
    pamela_reset_done(chn);
  }
  DC(']');
}

// ----- channel work -----

static void pamela_active_work(pamela_channel_t *chn)
{
  //DS("{act:"); DB(chn->chan_id); DC(':'); DW(chn->status); DC('}');
  pamela_handler_ptr_t handler = HANDLER_TABLE_GET_ENTRY(chn->service->srv_id);

  if(chn->status & PAMELA_STATUS_READ_PRE) {
    pamela_read_pre_work(chn, handler, PAMELA_CALL_NEXT);
  }
  if(chn->status & PAMELA_STATUS_READ_POST) {
    pamela_read_post_work(chn, handler, PAMELA_CALL_NEXT);
  }

  if(chn->status & PAMELA_STATUS_WRITE_PRE) {
    pamela_write_pre_work(chn, handler, PAMELA_CALL_NEXT);
  }
  if(chn->status & PAMELA_STATUS_WRITE_POST) {
    pamela_write_post_work(chn, handler, PAMELA_CALL_NEXT);
  }
}

static void pamela_channel_work(pamela_channel_t *chn)
{
  pamela_service_t *srv = chn->service;
  pamela_handler_ptr_t handler = HANDLER_TABLE_GET_ENTRY(srv->srv_id);

  switch(chn->status & PAMELA_STATUS_STATE_MASK) {
    case PAMELA_STATUS_OPENING:
      pamela_open_work(chn, handler, PAMELA_CALL_NEXT);
      break;
    case PAMELA_STATUS_CLOSING:
      pamela_close_work(chn, handler, PAMELA_CALL_NEXT);
      break;
    case PAMELA_STATUS_RESETTING:
      pamela_reset_work(chn, handler, PAMELA_CALL_NEXT);
      break;
    case PAMELA_STATUS_ACTIVE:
      pamela_active_work(chn);
      break;
    default:
      break;
  }
}

// ----- API functions  -----

u08 pamela_get_slot(u08 chn)
{
  pamela_channel_t *pc = pamela_get_channel(chn);
  return pc->slot_id;
}

u08 pamela_get_srv_id(u08 chn)
{
  pamela_channel_t *pc = pamela_get_channel(chn);
  return pc->service->srv_id;
}

pamela_handler_ptr_t pamela_get_handler(u08 chn)
{
  pamela_channel_t *pc = pamela_get_channel(chn);
  u08 srv_id = pc->service->srv_id;
  return HANDLER_TABLE_GET_ENTRY(srv_id);
}

void pamela_end_stream(u08 chn, u08 error)
{
  pamela_channel_t *pc = pamela_get_channel(chn);

  if(error == PAMELA_HANDLER_OK) {
    pamela_set_status(pc, PAMELA_STATUS_EOS);
  } else {
    pamela_set_error(pc, error);
  }

  DS("[eos:"); DB(chn); DC('='); DB(error); DC(']'); DNL;

  // notify host
  proto_io_event_mask_add_chn(chn);
}

void pamela_channel_task_control(u08 chn, u08 on)
{
  pamela_channel_t *pc = pamela_get_channel(chn);
  if(on) {
    DS("[task:on:"); DB(chn); DC(']'); DNL;
    pc->flags |= PAMELA_CHANNEL_FLAG_TASK;
  } else {
    DS("[task:off:"); DB(chn); DC(']'); DNL;
    pc->flags &= ~PAMELA_CHANNEL_FLAG_TASK;
  }
}
