cnvogelg/pardroid/amiga/src/pamela/pamela.h

#ifndef PAMELA_H
#define PAMELA_H

#include <exec/exec.h>

#include "timer.h"
#include "pamela/wire.h"
#include "pamela/devinfo.h"
#include "pamela/error.h"

/* wait event result */
#define PAMELA_WAIT_TIMEOUT              1
#define PAMELA_WAIT_SIGMASK              2
#define PAMELA_WAIT_EVENT                4

/* check if read req is done */
static inline int pamela_status_read_ready(UWORD status)
{
  return (status & PAMELA_STATUS_READ_READY) == PAMELA_STATUS_READ_READY;
}

/* check if write req is done */
static inline int pamela_status_write_ready(UWORD status)
{
  return (status & PAMELA_STATUS_WRITE_READY) == PAMELA_STATUS_WRITE_READY;
}

/* ----- Types ----- */

/* handle for pamela instance */
struct pamela_handle;
typedef struct pamela_handle pamela_handle_t;

/* pamela channel */
struct pamela_channel;
typedef struct pamela_channel pamela_channel_t;

/* ----- API ----- */

/* setup pamela */
pamela_handle_t *pamela_init(struct Library *SysBase, int *error);
/* shutdown pamela */
void pamela_exit(pamela_handle_t *ph);

/* error decoding */
const char *pamela_perror(int res);

/* access timer */
timer_handle_t *pamela_get_timer(pamela_handle_t *ph);

/* fill in devinfo struct */
void pamela_devinfo(pamela_handle_t *ph, pamela_devinfo_t *info);
/* return max channels */
int  pamela_get_max_channels(pamela_handle_t *ph);

/* wait for proto event, time out, or extra signals */
int pamela_event_wait(pamela_handle_t *ph,
                      ULONG timeout_s, ULONG timeout_us,
                      ULONG *extra_sigmask);
/* first retrieve (and clear) event mask from device
   then update status of all affected channels.
   see pamela_update().
*/
int pamela_event_update(pamela_handle_t *ph, UWORD *event_mask);

/* ----- open/close/reset ----- */
/* open channel to given service */
pamela_channel_t *pamela_open(pamela_handle_t *ph, UWORD port, int *error);
/* close channel */
int pamela_close(pamela_channel_t *pc);
/* reset current channel */
int pamela_reset(pamela_channel_t *pc);

/* ----- update/status ----- */
/* update channel state (and error if necessary) by querying device */
int pamela_update(pamela_channel_t *pc);
/* return local channel status */
UWORD pamela_status(pamela_channel_t *pc);
/* return error code of channel */
UWORD pamela_error(pamela_channel_t *pc);
/* return id 0..n of channel */
UBYTE pamela_channel_id(pamela_channel_t *pc);

/* ----- get_mtu/set_mtu ----- */
/* read mtu value from device */
int pamela_get_mtu(pamela_channel_t *pc, UWORD *mtu);
/* try to set new mtu value in device */
int pamela_set_mtu(pamela_channel_t *pc, UWORD mtu);

/* ----- seek/tell ----- */
/* seek to position */
int pamela_seek(pamela_channel_t *pc, ULONG pos);
/* get current position */
int pamela_tell(pamela_channel_t *pc, ULONG *pos);

/* ----- read ----- */
/* post read request. give max size */
int pamela_read_request(pamela_channel_t *pc, UBYTE *buf, UWORD size);
/* setup read operation and return actual size of transfer */
int pamela_read_setup(pamela_channel_t *pc);
/* read next block. return >0 if more blocks need to be read */
int pamela_read_block(pamela_channel_t *pc);

/* ----- write ----- */
/* post write requst. give max size */
int pamela_write_request(pamela_channel_t *pc, UBYTE *buf, UWORD size);
/* setup write operation and return actual size of transfer */
int pamela_write_setup(pamela_channel_t *pc);
/* write next block. return >0 if more blocks need to be written */
int pamela_write_block(pamela_channel_t *pc);

#endif /* PAMELA_H */
