cnvogelg/pardroid/amiga/src/pamela/pamela_int.h

#ifndef PAMELA_INT_H
#define PAMELA_INT_H

#include "proto/wire_io.h"

#define CHANNEL_FLAG_INACTIVE   0
#define CHANNEL_FLAG_BUSY       1
#define CHANNEL_FLAG_ACTIVE     2

struct pamela_channel {
  pamela_handle_t    *pamela;
  UBYTE               flags;
  UBYTE               channel_id;
  UWORD               status;
  UWORD               error;
  UWORD               port;
  UWORD               read_bytes;
  UWORD               write_bytes;
  UWORD               read_offset;
  UWORD               write_offset;
  UWORD               mtu;
  UBYTE              *read_buf;
  UBYTE              *write_buf;
};

struct pamela_handle {
  proto_env_handle_t *proto_env;
  proto_handle_t     *proto;
  struct Library     *sys_base;
  pamela_devinfo_t    devinfo;
  UWORD               token;

  pamela_channel_t    channels[PROTO_IO_NUM_CHANNELS];
};

extern int pamela_map_proto_error(int proto_error);
extern void pamela_channels_init(pamela_handle_t *ph);


#endif
