cnvogelg/pardroid/mcu/src/arch/mk20/arch.h

#ifndef ARCH_H
#define ARCH_H

#include "eeprom.h"
#include "nopgm.h"

#define INLINE        static inline
#define FORCE_INLINE  __attribute__((always_inline)) static inline
#define FAST_FUNC(x)  x

#endif
