cnvogelg/pardroid/mcu/src/arch/mk20/hw_led.c

#include "kinetis.h"

#include "hw_led.h"

void hw_led_init(void)
{
  // setup GPIO pin 13 aka PC5
  PORTC_PCR5 = (uint32_t)(1 << 8);
  GPIOC_PDDR |= (uint32_t)(1 << 5);
  GPIOC_PCOR |= (uint32_t)(1 << 5);
}

void hw_led_exit(void)
{
  GPIOC_PDDR &= ~(uint32_t)(1 << 5);
  GPIOC_PCOR |= (uint32_t)(1 << 5);
}

void hw_led_set(int on)
{
  if(on) {
    GPIOC_PSOR |= (uint32_t)(1 << 5);
  } else {
    GPIOC_PCOR |= (uint32_t)(1 << 5);
  }
}
