cnvogelg/pardroid/mcu/src/arch/mk20/hw_timer.h

#ifndef HW_TIMER_H
#define HW_TIMER_H

#include <stdint.h>
#include "arch.h"

typedef uint32_t hw_timer_ms_t;

extern volatile hw_timer_ms_t systick_millis_count;

extern void hw_timer_delay_ms(uint32_t ms);

INLINE hw_timer_ms_t hw_timer_millis(void)
{
    volatile hw_timer_ms_t ret = systick_millis_count;
    return ret;
}

INLINE int hw_timer_millis_timed_out(hw_timer_ms_t start, uint16_t timeout)
{
    return (hw_timer_millis() - start) > timeout;
}

/* from Teensyduino: core_pins.h */
FORCE_INLINE void hw_timer_delay_us(uint32_t usec)
{
#if F_CPU == 240000000
    uint32_t n = usec * 80;
#elif F_CPU == 216000000
    uint32_t n = usec * 72;
#elif F_CPU == 192000000
    uint32_t n = usec * 64;
#elif F_CPU == 180000000
    uint32_t n = usec * 60;
#elif F_CPU == 168000000
    uint32_t n = usec * 56;
#elif F_CPU == 144000000
    uint32_t n = usec * 48;
#elif F_CPU == 120000000
    uint32_t n = usec * 40;
#elif F_CPU == 96000000
    uint32_t n = usec << 5;
#elif F_CPU == 72000000
    uint32_t n = usec * 24;
#elif F_CPU == 48000000
    uint32_t n = usec << 4;
#elif F_CPU == 24000000
    uint32_t n = usec << 3;
#elif F_CPU == 16000000
    uint32_t n = usec << 2;
#elif F_CPU == 8000000
    uint32_t n = usec << 1;
#elif F_CPU == 4000000
    uint32_t n = usec;
#elif F_CPU == 2000000
    uint32_t n = usec >> 1;
#endif
    // changed because a delay of 1 micro Sec @ 2MHz will be 0
    if (n == 0) return;
    __asm__ volatile(
        "L_%=_timer_delay_us:"       "\n\t"
#if F_CPU < 24000000
        "nop"                   "\n\t"
#endif
        "subs   %0, #1"             "\n\t"
        "bne    L_%=_timer_delay_us"     "\n"
        : "+r" (n) :
    );
}

#define hw_timer_delay_1us() hw_timer_delay_us(1)

#endif
