cnvogelg/pardroid/mcu/src/arch/avr/hw_led.c

#include "autoconf.h"
#include "types.h"

#include "hw_led.h"

void hw_led_init(void)
{
  LED_DDR  |= LED_MASK;
  LED_PORT &= ~LED_MASK;
}

void hw_led_exit(void)
{
  LED_DDR &= ~LED_MASK;
  LED_PORT &= ~LED_MASK;
}

void hw_led_set(u08 on)
{
  if(on) {
    LED_PORT |= LED_MASK;
  } else {
    LED_PORT &= ~LED_MASK;
  }
}
