cnvogelg/pardroid/(commit log)

2017-01-02 some avr assembly
2017-01-13 added timer
2017-01-13 fixed timer restart
2017-03-28 added avrnetio board
2017-03-28 added teensy20 board
2017-03-29 added pbnano fuses
2017-04-09 added signal based timer
2017-04-29 disable pin debug by default
2017-05-07 teensy20 fixes
2017-05-07 fixed teensy20 pin doc
2017-05-07 teensy20 requires ISP
2017-06-13 switch to cmd bits in idle byte
2017-10-26 abort read if message is too large
    [proto.c, test-main.c]
2017-10-31 added driver
2017-11-08 started teensy32 port
2017-11-17 started enc28j60 driver
2017-11-20 sd: get capacity
2017-11-22 handle reset with knok exit
    [knok.c, knok.h, proto.c, proto.h, strobe.c]
2017-11-24 mk20: added spi
2017-11-30 new teensy20 parallel pinout
2017-12-01 started wiznet driver
2017-12-12 driver rework
2017-12-13 driver rewrite
2017-12-16 added eeprom support for teensy3
2017-12-23 use leds for knok
2017-12-26 spi and crc is now in base
2017-12-29 fixed extra word in test-pamela. fixed bootloader size
    [bootloader.c, proto.c, proto.h]
2018-01-03 started ufat driver
2018-01-12 renamed error flag to event_mask
    [mem.c]
2018-01-12 allow to replace msg io
    [proto.c, proto.h]
2018-01-19 reworked pamela Amiga API
    [bootloader.c, pablo.c, pamela.c, pamela.h, timer.h]
2018-01-20 fixed dist and fixed bootloader
    [bootloader.c]
2018-01-29 proto: set status correctly after msg read/write
    [proto.c]
2018-01-30 added busy. fixed write too large sync
    [pamela.c, proto.c, strobe.c, timer.h]
2019-04-02 adapted teensy3 port
2019-04-18 fixed read too large msg
    [proto.c, proto.h]
2019-07-19 fixed handling of too large msg writes
    [bootbase.c, proto.c, proto.h]
2019-07-19 added direct spi msg transfer
2019-07-25 added spi block commands for common
2019-07-28 fixed spi use after spi msg transfer
    [enc28j60.c]
2019-07-28 added enc to teensy32
2019-08-01 fix bootloader page size
    [bootloader.c]
2019-10-10 started pambox.device
2019-10-11 renamed pamela.device
2019-10-11 correctly renamed pamela.device
2019-10-11 new pamnet device
2019-12-13 added msg spi tests
2020-01-06 added teensy 2.0 hardware
    [parbox_t2.kicad_pcb, parbox_t2.sch]
2020-01-09 added Teensy 3.2 hardware
    [parbox_t32.kicad_pcb, parbox_t32.sch]
2020-01-22 hw: update t2 rev 1.4
    [parbox_t2.kicad_pcb, parbox_t2.sch]
2020-02-15 added mk20 i2c driver
2020-02-15 faster i2c
2021-11-22 fixed proto atom minitest
    [proto_atom.c]
2021-11-22 fix mini test proto dev
    [proto_dev.c]
2022-02-11 hw: added new base board and pico
    [pb_base.kicad_pcb, pb_base.kicad_sch, pb_cpu_pipico.kicad_pcb, pb_cpu_pipico.kicad_sch, pb_spi_net.kicad_pcb, pb_spi_net.kicad_sch]
2022-03-01 hw: updated base and pico to 0.2
    [pb_base.kicad_pcb, pb_base.kicad_sch, pb_cpu_pipico.kicad_pcb, pb_cpu_pipico.kicad_sch]
2022-03-03 initial support for pico
2022-03-05 fixed pico uart
2022-03-05 pico fixes
2022-03-06 fixed slow pico funcs
    [arch.h]
2022-03-06 pico strobe fixes
2022-04-07 added pamela.device
2022-04-15 async open/reset/close in pamela
    [pamela.c, pamela.h, pamela_chn.c, pamela_handler.h, pamela_int.h, pamela_io.c]
2022-04-26 fixed enc28j60 test
    [pb_spi_net.kicad_sch]
2022-11-25 added proto_io channel error
    [proto_io.c, proto_io.h]
2022-11-25 pamela: added open error handling/tests
    [pamela.c, pamela.h, pamela_chn.c, pamela_int.h, pamela_io.c]
2022-11-25 added tests for read/write errors
    [pamela.c, pamela.h, pamela_handler.h, pamela_int.h, pamela_io.c]
2022-11-25 added error tests to pamela engine
    [error.h, pamela.h]
2023-01-20 fix pamela multi block r/w
    [pamela.h, pamela_io.c]
2023-01-20 add zero/short read/write tests
    [pamela.h, pamela_io.c]
